AshtonDudley/eced3901-2026-team08/docs/course-photos/PXL_20260109_200601656.jpg

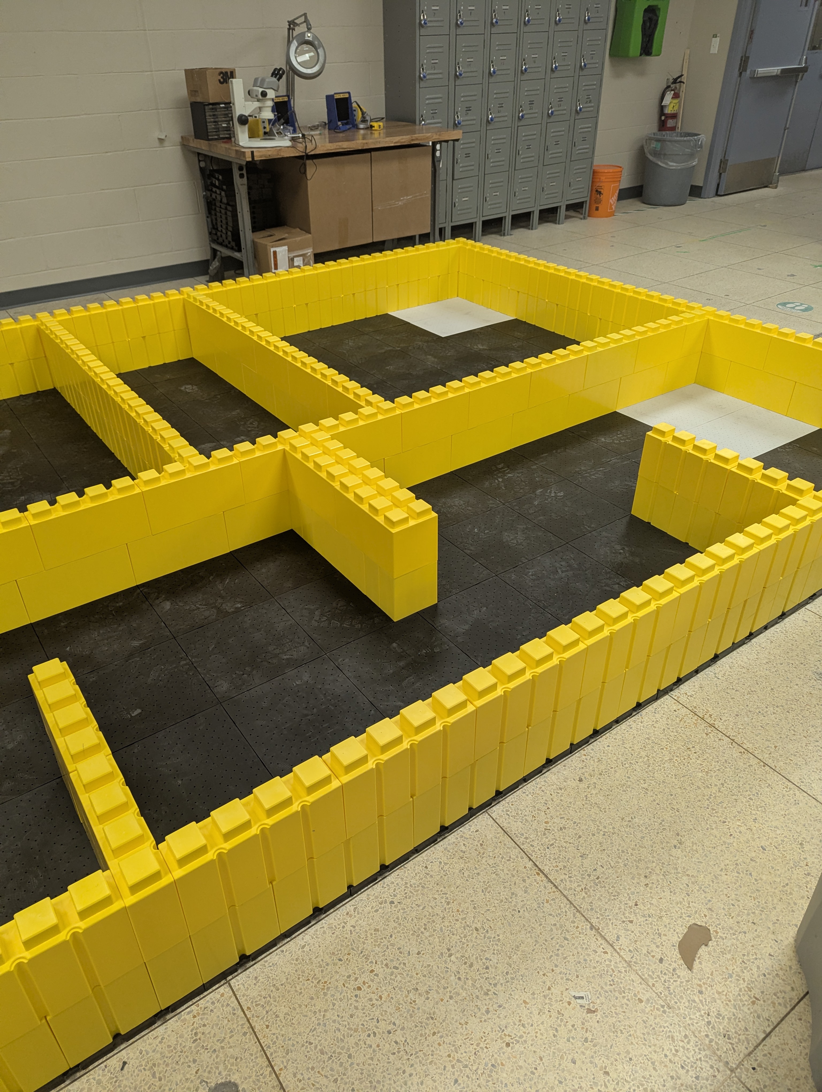
docs/course-photos/PXL_20260109_200601656.jpg
