AshtonDudley/eced3901-2026-team08/hardware/BOM/BOM_ECED3901.csv

Item | Quantity | Manufacturer | MPN | Supplier | Supplier PN | Unit Cost | Extended Cost | Notes
Emagnet | 1 | Adafruit | 3874 | DigiKey | 1528-2690-ND | 23.05 | 23.05 | SecretWeapon2KgStrength
WS28128B | 15 | SparkFun Electronics | 16347 | DigiKey | 1568-16347TR-ND | 0.68 | 10.2
