AshtonDudley/eced3901-2026-team08/hardware/cargo/ShippingCargoV3.step

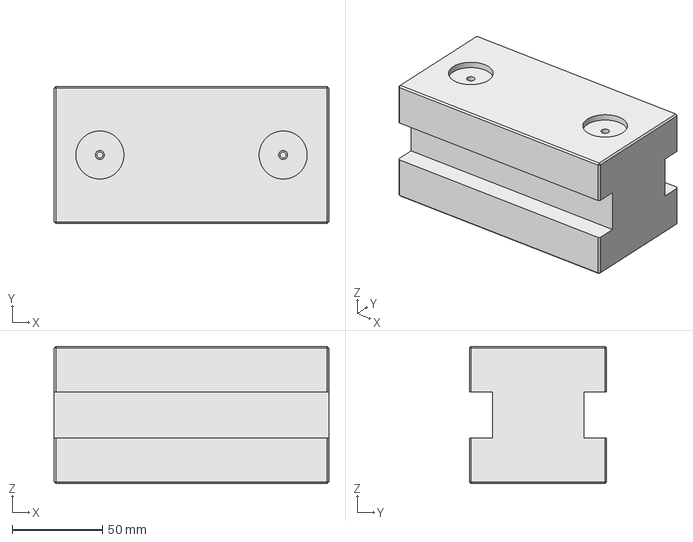
[picture p20: CAD file, 2026-01-12]
hardware/cargo/ShippingCargoV3.step
152.4 x 76.2 x 76.2 mm
