AshtonDudley/eced3901-2026-team08/hardware/course/course-map.SLDPRT

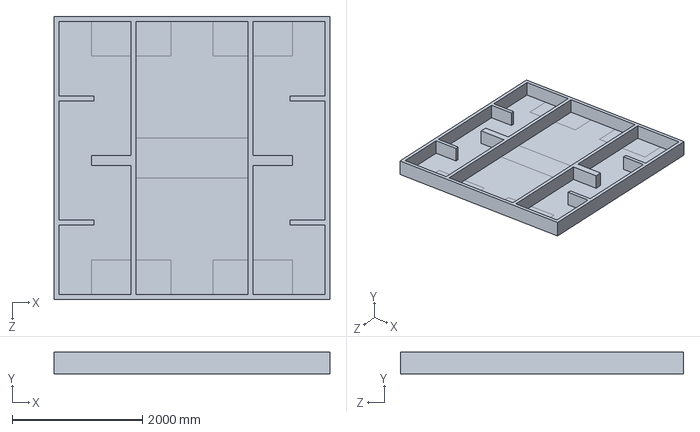
[picture p21: CAD file, 2026-01-12]
hardware/course/course-map.SLDPRT
4229.1 x 330.2 x 4343.4 mm
