AshtonDudley/eced3901-2026-team08/models/Emag.SLDPRT

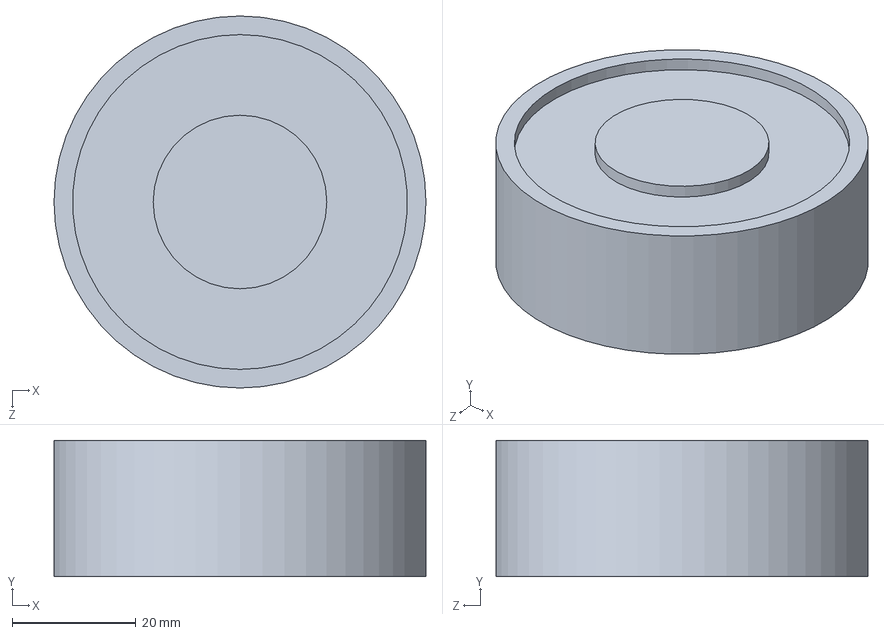
[picture p22: CAD file, 2026-02-25]
models/Emag.SLDPRT
60.0 x 22.0 x 60.0 mm
