AshtonDudley/eced3901-2026-team08/hardware/indicator_case/LED_Top.SLDPRT

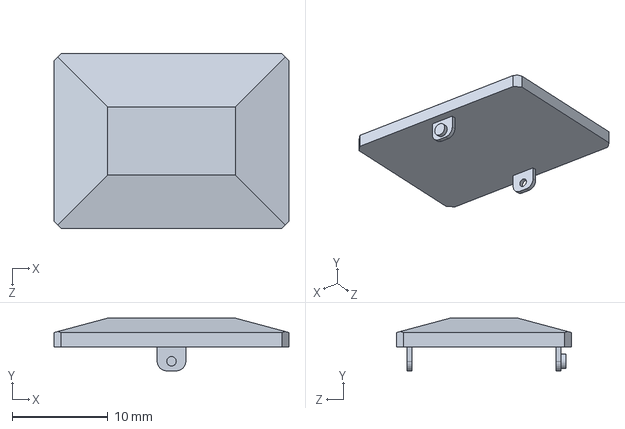
[picture p23: CAD file, 2026-01-25]
hardware/indicator_case/LED_Top.SLDPRT
24.5 x 5.50 x 18.2 mm
