AshtonDudley/eced3901-2026-team08/models/Arm.SLDPRT

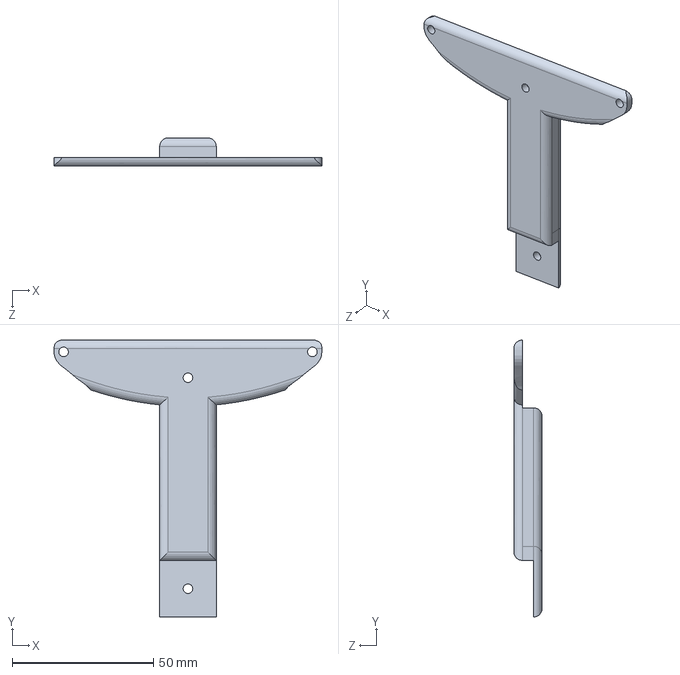
[picture p24: CAD file, 2026-02-25]
models/Arm.SLDPRT
94.8 x 97.9 x 10.0 mm
