AshtonDudley/eced3901-2026-team08/hardware/indicator_case/LED_PCB.step

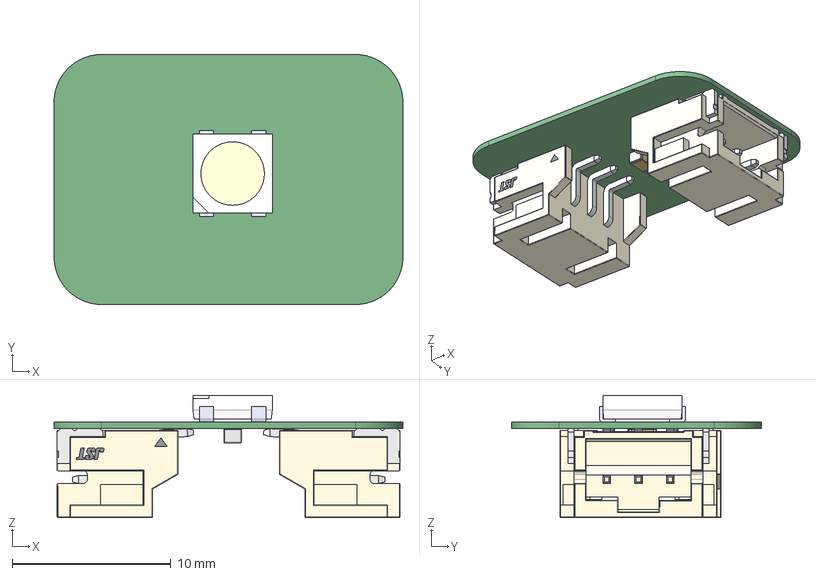
[picture p25: CAD file, 2026-01-25]
hardware/indicator_case/LED_PCB.step
22.0 x 15.8 x 7.70 mm
User Library-WS2812B
Pin1_Triangle x 2
JST x 2
