AshtonDudley/eced3901-2026-team08/models/Lifeboat_Bin.SLDPRT

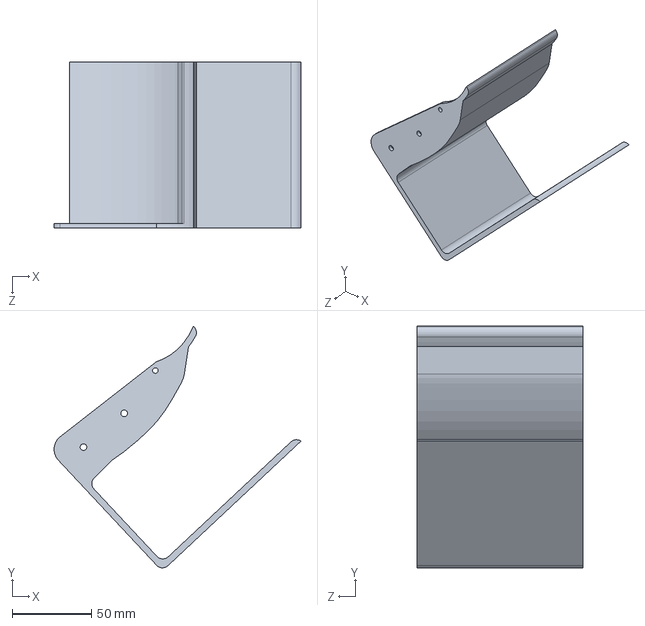
[picture p26: CAD file, 2026-02-25]
models/Lifeboat_Bin.SLDPRT
155.8 x 152.5 x 105.0 mm
