AshtonDudley/eced3901-2026-team08/hardware/indicator_case/LED_Case.SLDASM

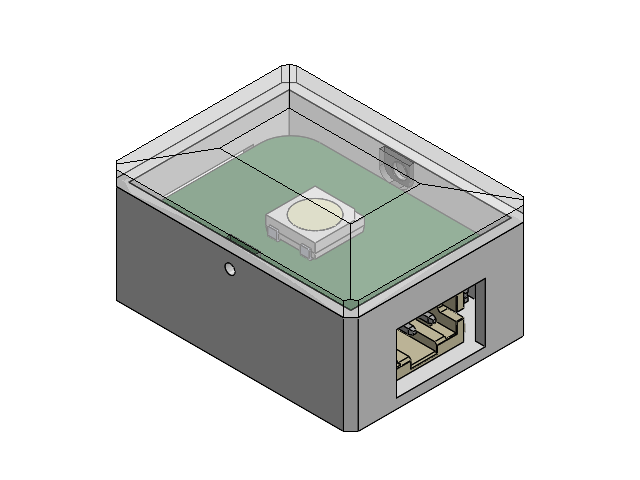
[picture p27: CAD file, 2026-01-25]
hardware/indicator_case/LED_Case.SLDASM
LED_Case
LED_Top
User Library-WS2812B.step
1.step x 2
2.step x 2
Pin1_Triangle.step x 2
JST.step x 2
