AshtonDudley/eced3901-2026-team08/(list of files, cad)

Other CAD files:
hardware/indicator_case/LED_Case.SLDPRT
