AshtonDudley/eced3901-2026-team08/labs/lab2/Testing.md

Group 8

DT2 testing

2026-01-28 - Liam Testing
Changed file
'lab5dt2.launch.py'
to make a map called dt2_map
Was using old eced_dt1.cpp

Tested in person and map generated

Need to test in Gazebo
