AshtonDudley/eced3901-2026-team08/hardware/bot-sch/20231119 dalibot SCH.pdf

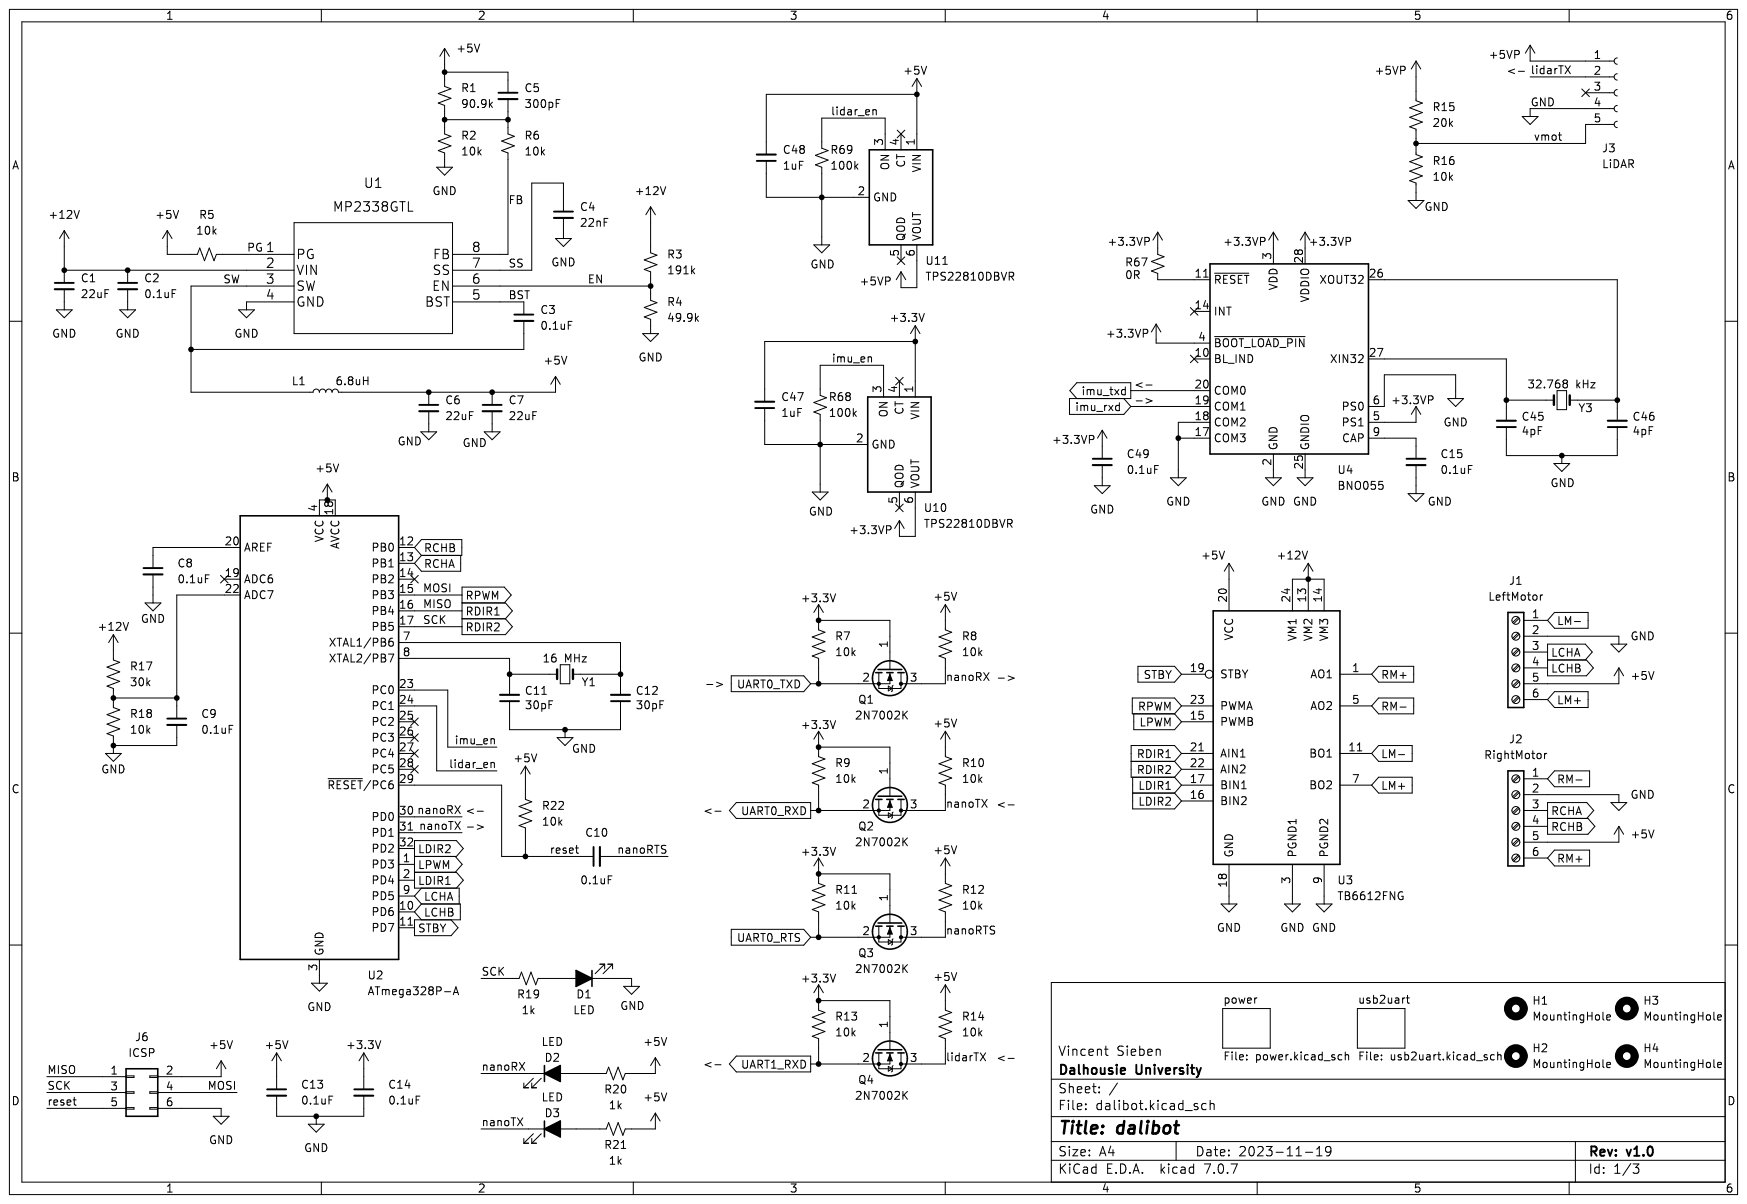
[picture p28: page 1]

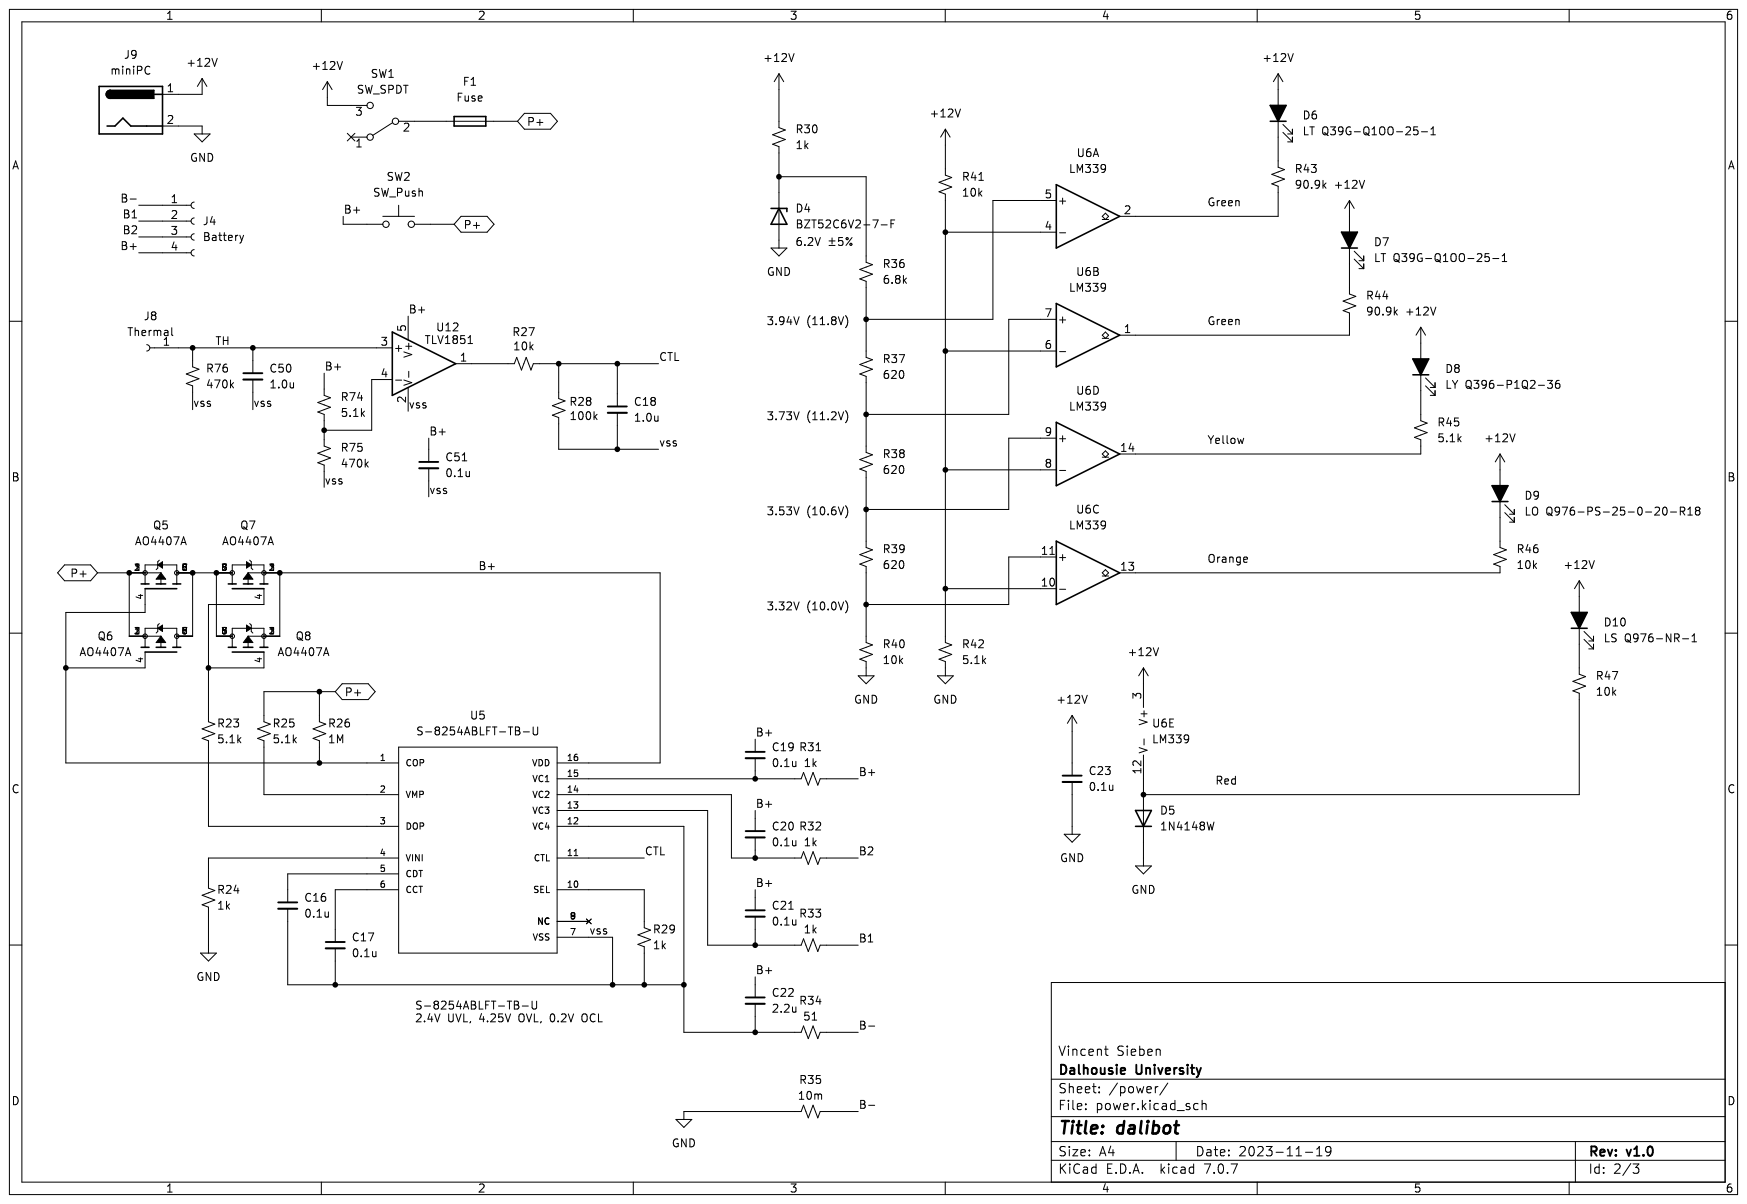
[picture p29: page 2]

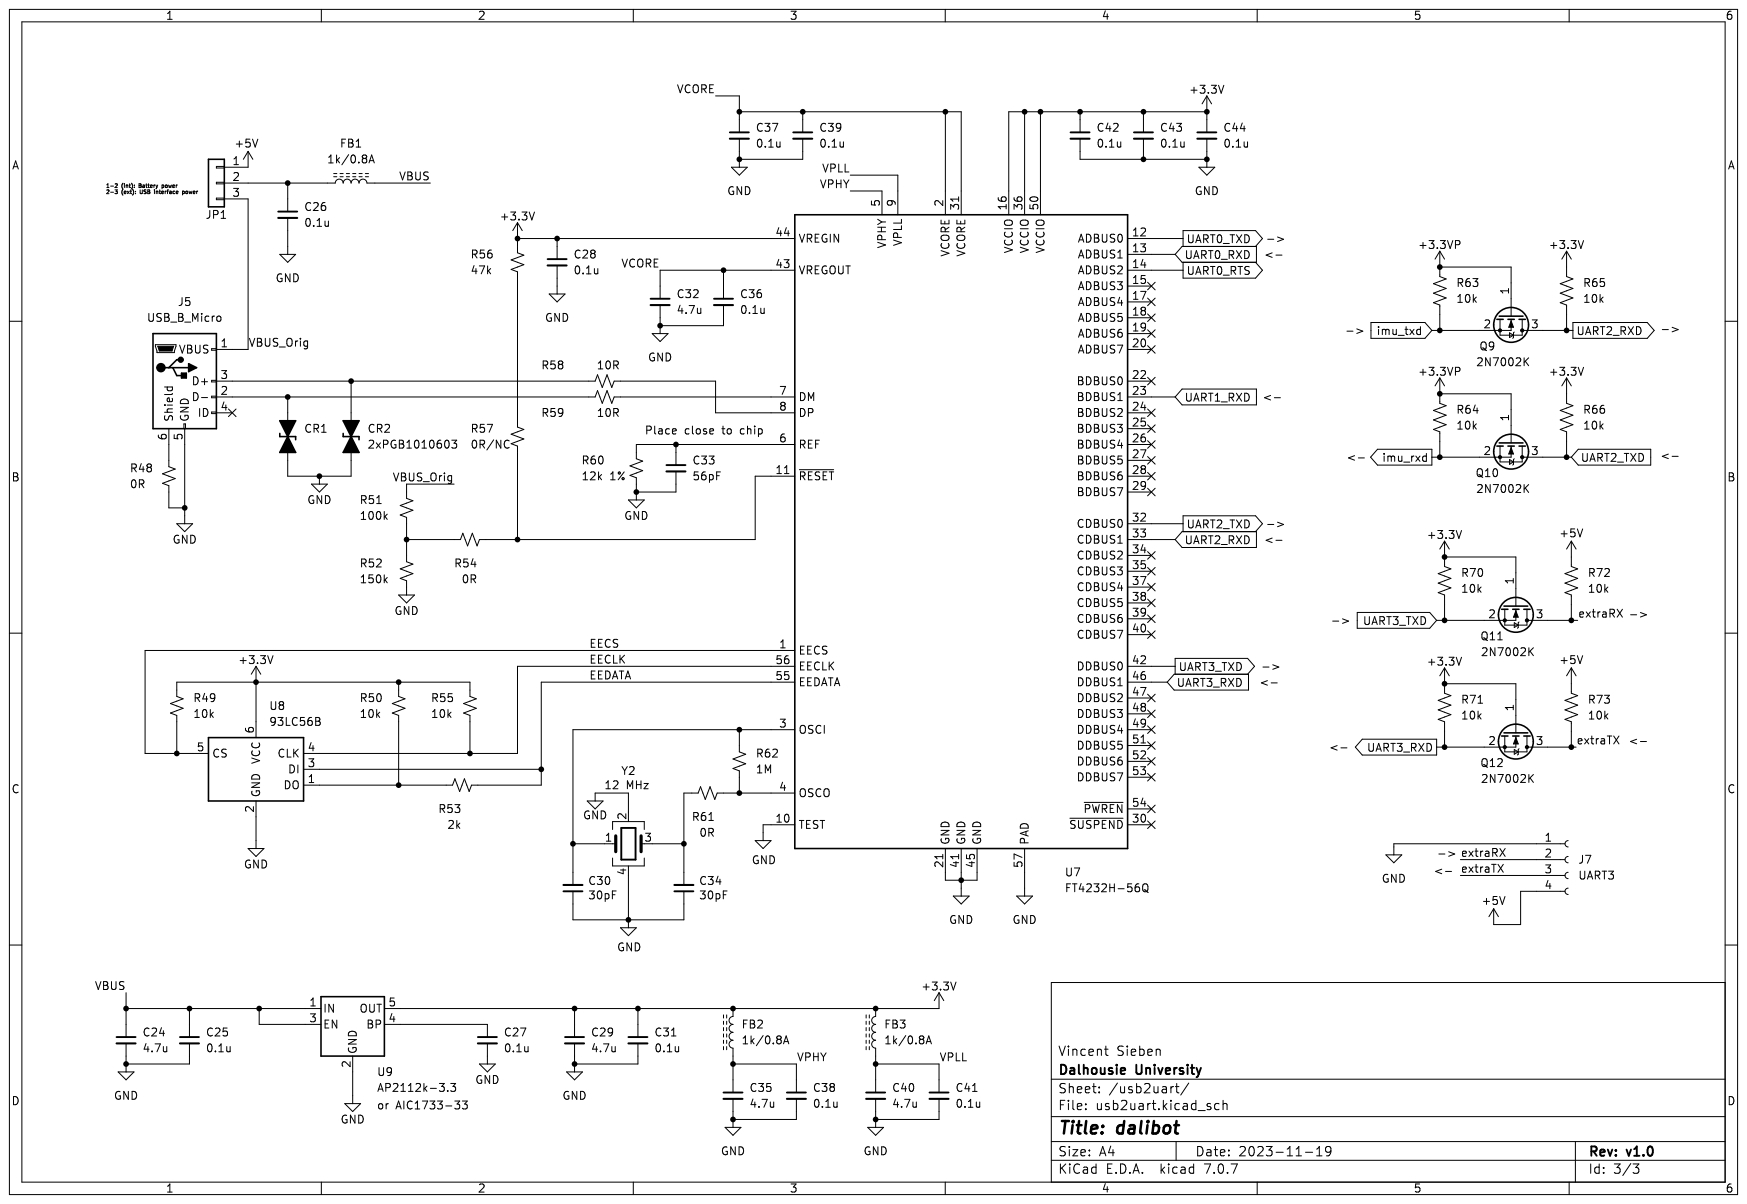
[picture p30: page 3]
