AshtonDudley/eced3901-2026-team08/(list of files, drawings)

Other design files:
hardware/indicator/indicator.PrjPcb
hardware/indicator/LED.PcbDoc
hardware/indicator/LED.SchDoc
hardware/system/captain_phillips.SchDoc
hardware/system/emag.SchDoc
hardware/system/indicator.SchDoc
hardware/system/microcontroller.SchDoc
hardware/system/overview.SchDoc
hardware/system/power_supply.SchDoc
hardware/system/sonar.SchDoc
hardware/system/system-schematic.PrjPcb
hardware/system/ws2812b.SchDoc
