AshtonDudley/eced3901-2026-team08/hardware/firmware/firmware.ioc

Mcu.UserName=STM32G0B1RETx
PA0.Signal=ADC1_IN0
PA1.Signal=ADC1_IN1
PA13.Signal=SYS_SWDIO
PA14-BOOT0.Signal=SYS_SWCLK
PA2.Signal=ADC1_IN2
PA5.Signal=S_TIM2_CH1_ETR
PA8.Signal=S_TIM1_CH1
PC0.Signal=GPIO_Output
PC1.Signal=GPIO_Output
PC10.Signal=USART4_TX
PC11.Signal=USART4_RX
PC2.Signal=GPIO_Output
PC3.Signal=GPIO_Output
PD2.Signal=USART5_RX
PD3.Signal=USART5_TX
