AshtonDudley/eced3901-2026-team08/(commit log)

2026-01-08 Added folders (#4)
    * Added folders
    * Datasheets for Components
    * Schematic and BOM
    ---------
2026-01-12 3 Added course (#17)
    * Added course map
    * Update .gitignore
    * Added colour and pirate zone
    * Added cargo
    [ShippingCargoV3.step, course-map.SLDPRT]
2026-01-16 Added files from robot (#21)
    [eced3901bot.urdf, model.sdf]
2026-01-19 Added Altium Overall Schematic (#28)
    * Added Altium Overall Schematic
    Add everyone system components to this doc. Then the PCBs can be put into another folder.
    * Added altium .gitignore
    * Reapply .gitignore
    * moved bot
    * Added initial system scheamtic
    * Added CP
    * Added power supply
    * Added indicator led pcb
    * Updated altium project
    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
    [captain_phillips.SchDoc, indicator.SchDoc, overview.SchDoc, power_supply.SchDoc, system-schematic.PrjPcb]
2026-01-19 3 altium dev (#34)
    * Added pages for uC IO
    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
    [captain_phillips.SchDoc, emag.SchDoc, microcontroller.SchDoc, overview.SchDoc, sonar.SchDoc, system-schematic.PrjPcb, ws2812b.SchDoc]
2026-01-21 Created the BOM(#29)
    [BOM_ECED3901.csv]
2026-01-23 Add 1D LIDAR Sensor Sheet (#43)
2026-01-23 Fix formatting in BOM_ECED3901.csv (#44)
    [BOM_ECED3901.csv]
2026-01-23 3 Added STM32G0 IOC file (#33)
    * Started ioc file
    * Added STM32CubeMX Project Files v2
    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
2026-01-25 Added LED project (#36)
    * added led.sch for one pcb
    * Added led circuit and connectors
    * Update system overview schematic
    Modified the overview.SchDoc file in the hardware/system directory. The changes likely reflect updates to the system schematic, such as component adjustments or layout improvements.
    * Update system schematic files
    Modified indicator, overview, and ws2812b schematic documents in the hardware/system directory. Changes may include component updates or wiring adjustments.
    * Deleted mounting pins
    * Added new PCB Project for Indicator
    * Add LED indicator schematic and PCB files
    Added LED.SchDoc and LED.PcbDoc to the hardware/indicator directory. Updated indicator.PrjPc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
    [LED.PcbDoc, LED.SchDoc, LED_Case.SLDASM, LED_Case.SLDPRT, LED_PCB.step, LED_Top.SLDPRT, captain_phillips.SchDoc, emag.SchDoc]
2026-01-25 7 altium add cut off (#46)
    * Added LV cuttoff to EN pin
    * Saved project
    [power_supply.SchDoc]
2026-01-30 4-dt2 (#48)
    * Updated the dt2 launch file
    * Changed the file to print to a dt2_map
    * Added updates to testing doc
2026-01-30 Add testing documentation for Emag current draw (#52)
    Documented testing procedures and results for Emag current draw under various load conditions.
2026-02-03 1 Added link to assignment 2 (#54)
    * Added Assn 2 pdf and word file link
    * Added LEDs to BOM to be ordered for Monday
    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
    [BOM_ECED3901.csv]
2026-02-13 Added datasheets for leds and nucleo board, also removed the software file because it's on a new repo (#57)
2026-02-25 Models for Arm and Lifeboat bucket (#62)
    Also included Emagnet
    [Arm.SLDPRT, Emag.SLDPRT, Lifeboat_Bin.SLDPRT]
2026-03-04 Add sensor_msgs dependency and new executables (#68)
    * Add sensor_msgs dependency and new executables
    * Update executable sources in CMakeLists.txt
2026-03-13 100 team qualification (#76)
    * nav testing file
    * create qualificaiton launch file
    * update cmake
    * try less wp
    * test with false sim time
    * all sim times false
    * update
    * new wps
    * new wps
    * update yaw
    * deleted build files (#78)
    * Delete src/nav_tesing.cpp
    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
2026-04-07 80 add cargo pickupdropoff logic (#85)
    * waypoint nav
    * update names
    * update map
    * update right coast wps
    * try switching
    * update robot radius
    * update exe
    * update waypoint switch logic
    * testing waypoint switching
    * update wp
    * update wps
    * update inflation radius
    * update params
    * inflation radius
    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
